dsantorojr/velocity/JP-autoset-main/autoset-main-terminal-definitions.png

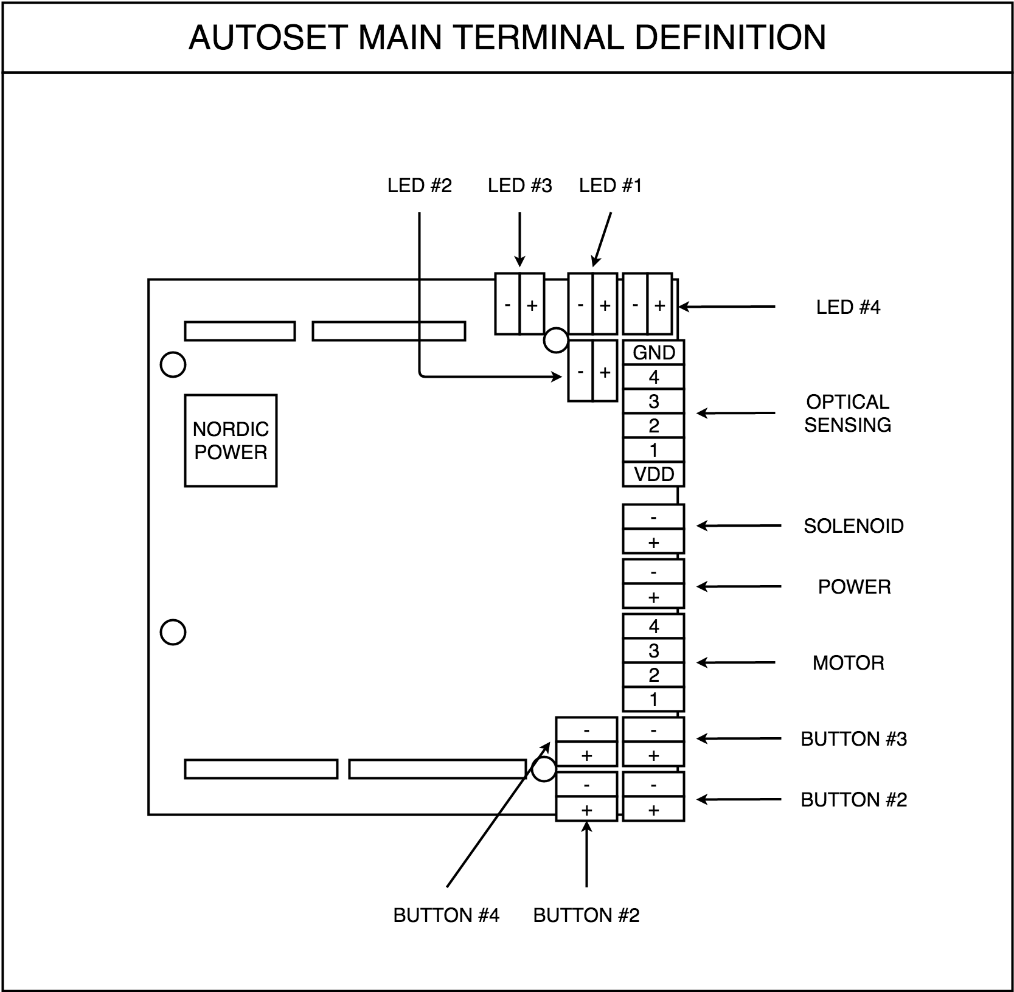
JP-autoset-main/autoset-main-terminal-definitions.png
