dsantorojr/velocity/JP-autoset-sensing-2/autoset-sensing-terminal-definition.png

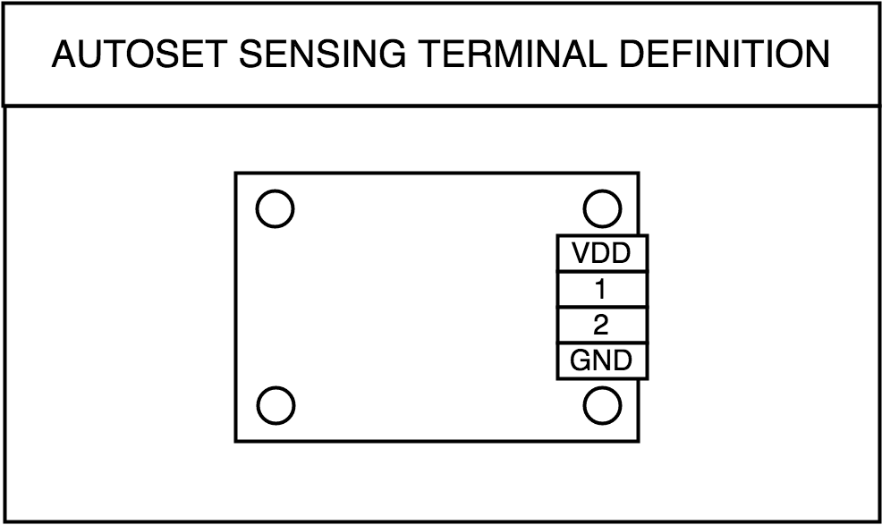
JP-autoset-sensing-2/autoset-sensing-terminal-definition.png
