dsantorojr/velocity/JP-autoset-main/autoset-main-in.dxf

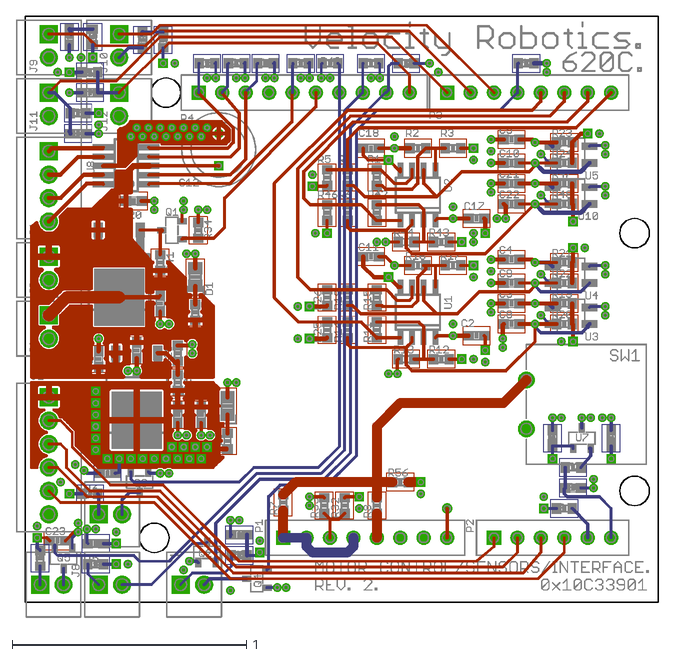
[picture p3: CAD file, 2017-01-25]
JP-autoset-main/autoset-main-in.dxf
2.74 x 2.57
