dsantorojr/velocity/JP-autoset-main/autoset-main-mm.dxf

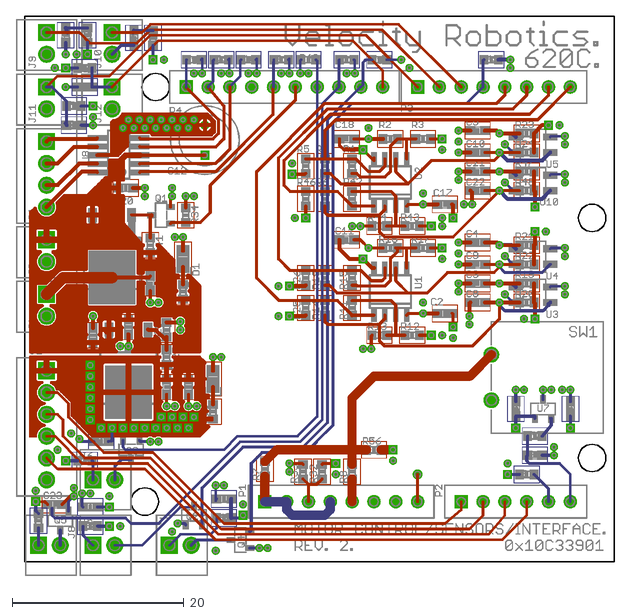
[picture p4: CAD file, 2017-01-25]
JP-autoset-main/autoset-main-mm.dxf
69.6 x 65.2
