dsantorojr/velocity/JP-autoset-sensing-2/autoset-sensing-mm.dxf

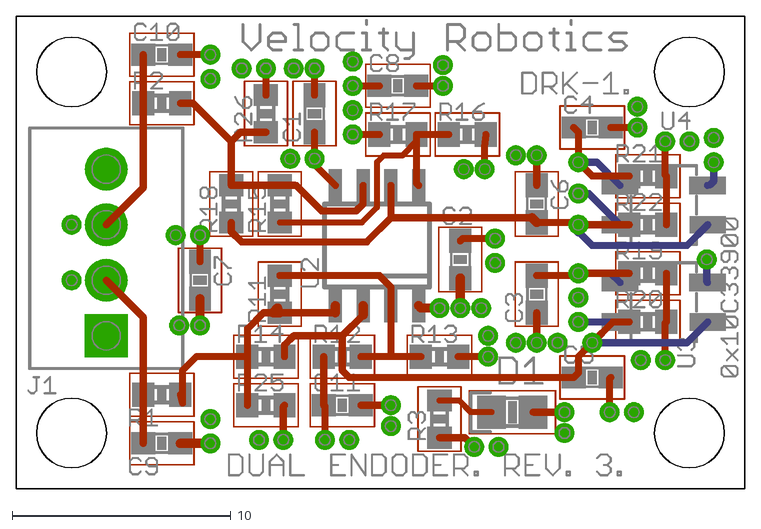
[picture p5: CAD file, 2017-01-25]
JP-autoset-sensing-2/autoset-sensing-mm.dxf
33.3 x 21.6
