dsantorojr/velocity/MF-autoset-motor-control/power-motor.dxf

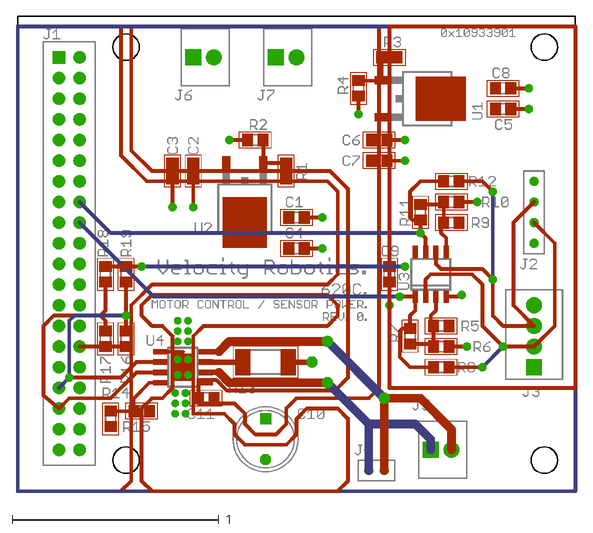
[picture p6: CAD file, 2016-12-03]
MF-autoset-motor-control/power-motor.dxf
2.72 x 2.31
