dsantorojr/velocity/MF-autoset-sensing/dual-encoding.dxf

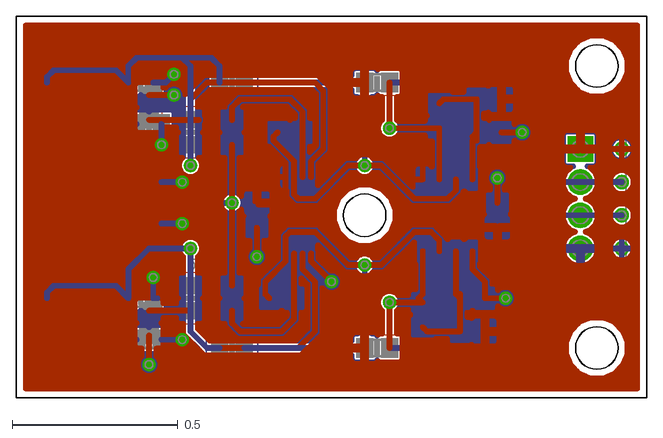
[picture p7: CAD file, 2016-12-03]
MF-autoset-sensing/dual-encoding.dxf
1.90 x 1.15
