dsantorojr/velocity/JP-autoset-sensing-2/autoset-sensing-in.dxf

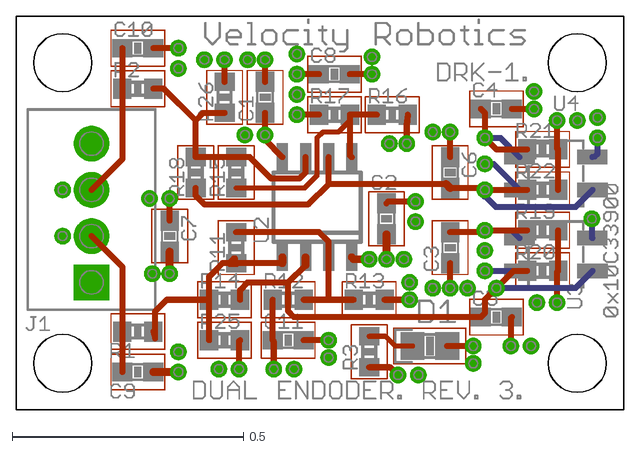
[picture p8: CAD file, 2017-01-25]
JP-autoset-sensing-2/autoset-sensing-in.dxf
1.31 x 0.85
