dsantorojr/velocity/JP-autoset-main/autoset-main-schematic.pdf

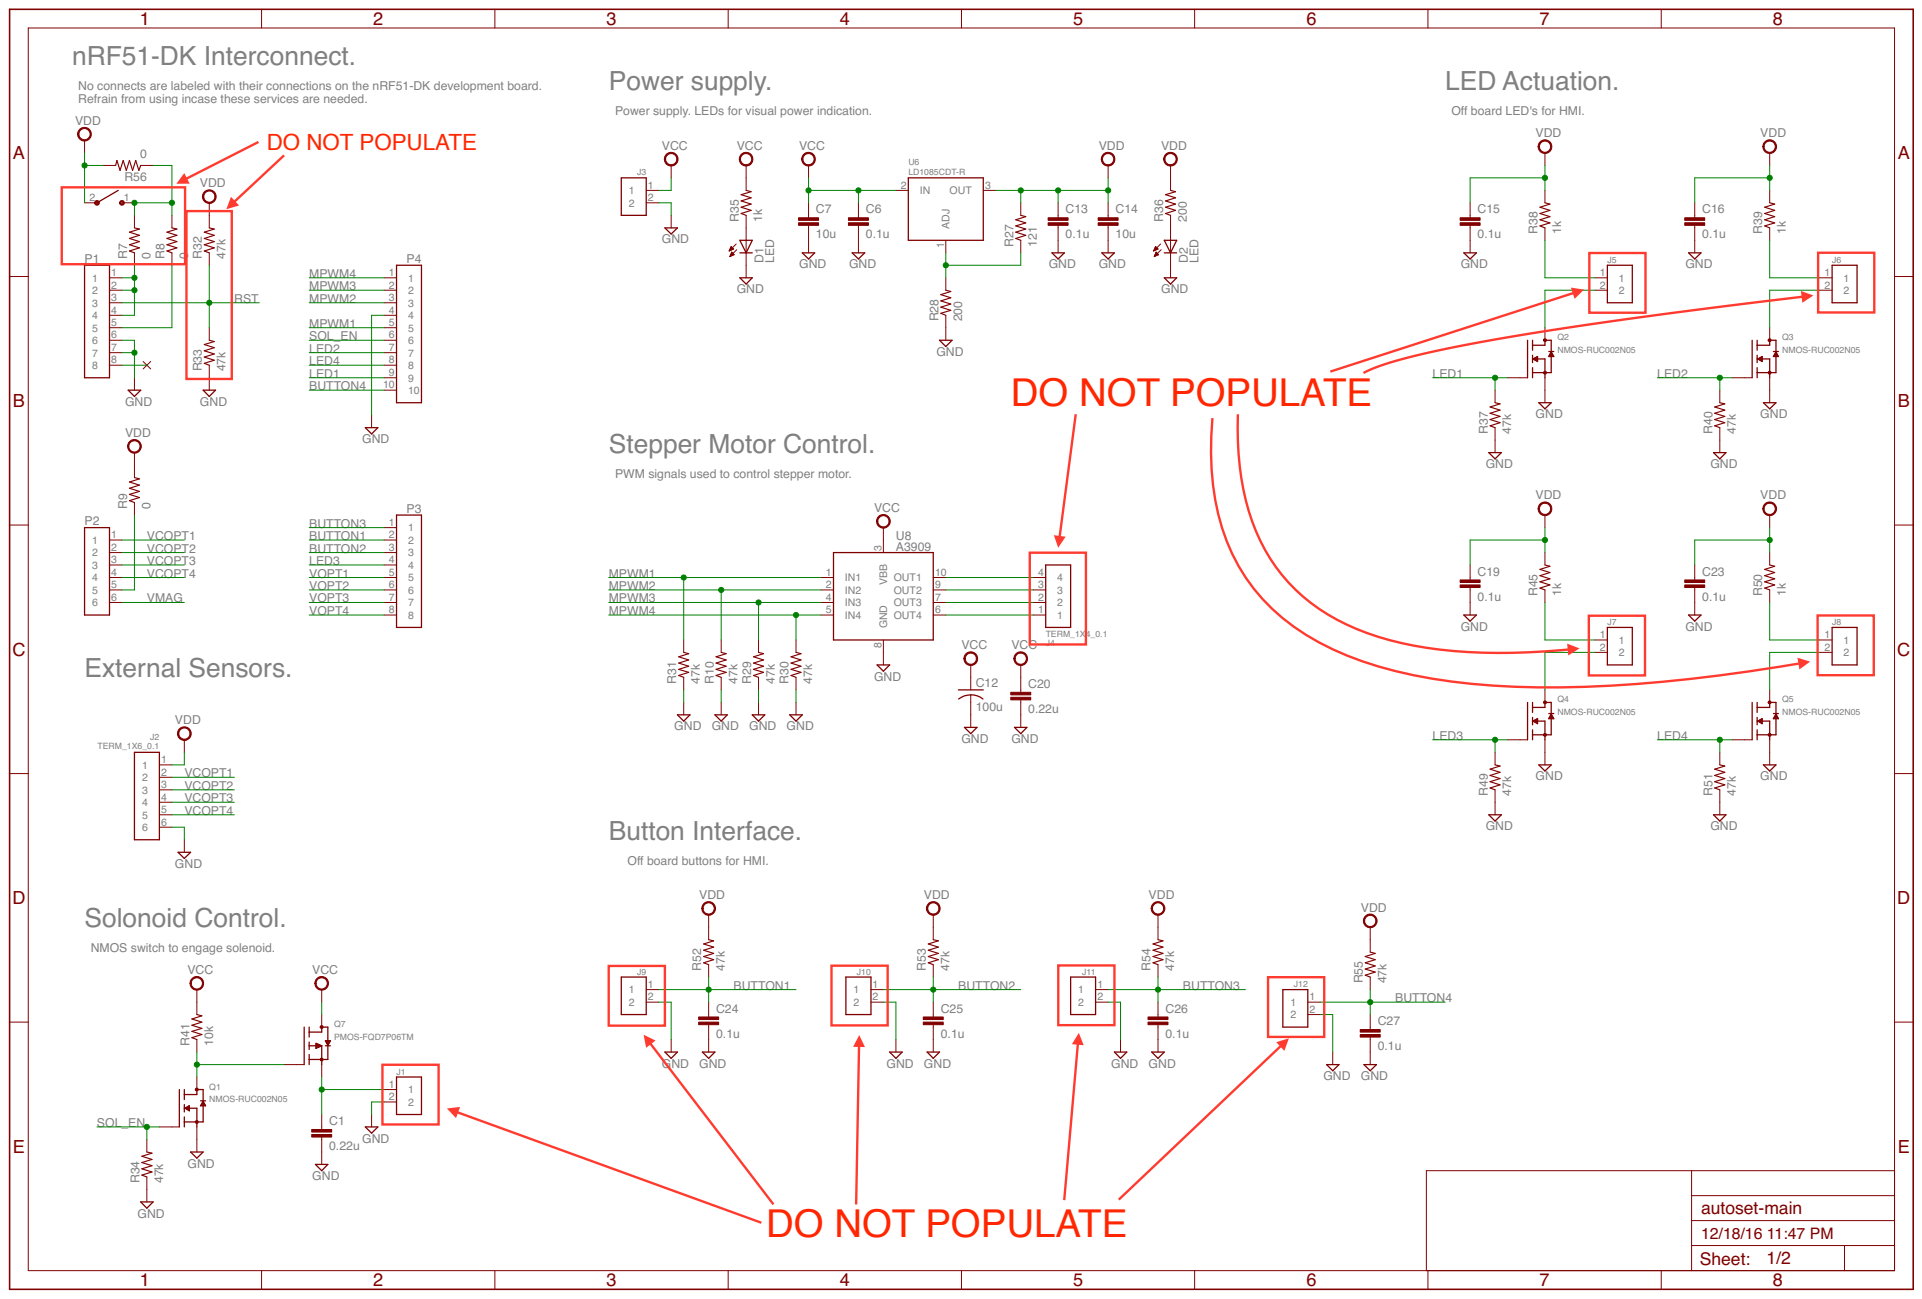
[picture p9: page 1]

nRF51-DK Interconnect. No connects are labeled with their connections on the nRF51-DK development board.

Power supply. Power supply. LEDs for visual power indication.

LED Actuation. Off board LED's for HMI.

Refrain from using incase these services are needed.
VDD

Stepper Motor Control. PWM signals used to control stepper motor.

GND GND

Button Interface. Off board buttons for HMI.

Solonoid Control. NMOS switch to engage solenoid.

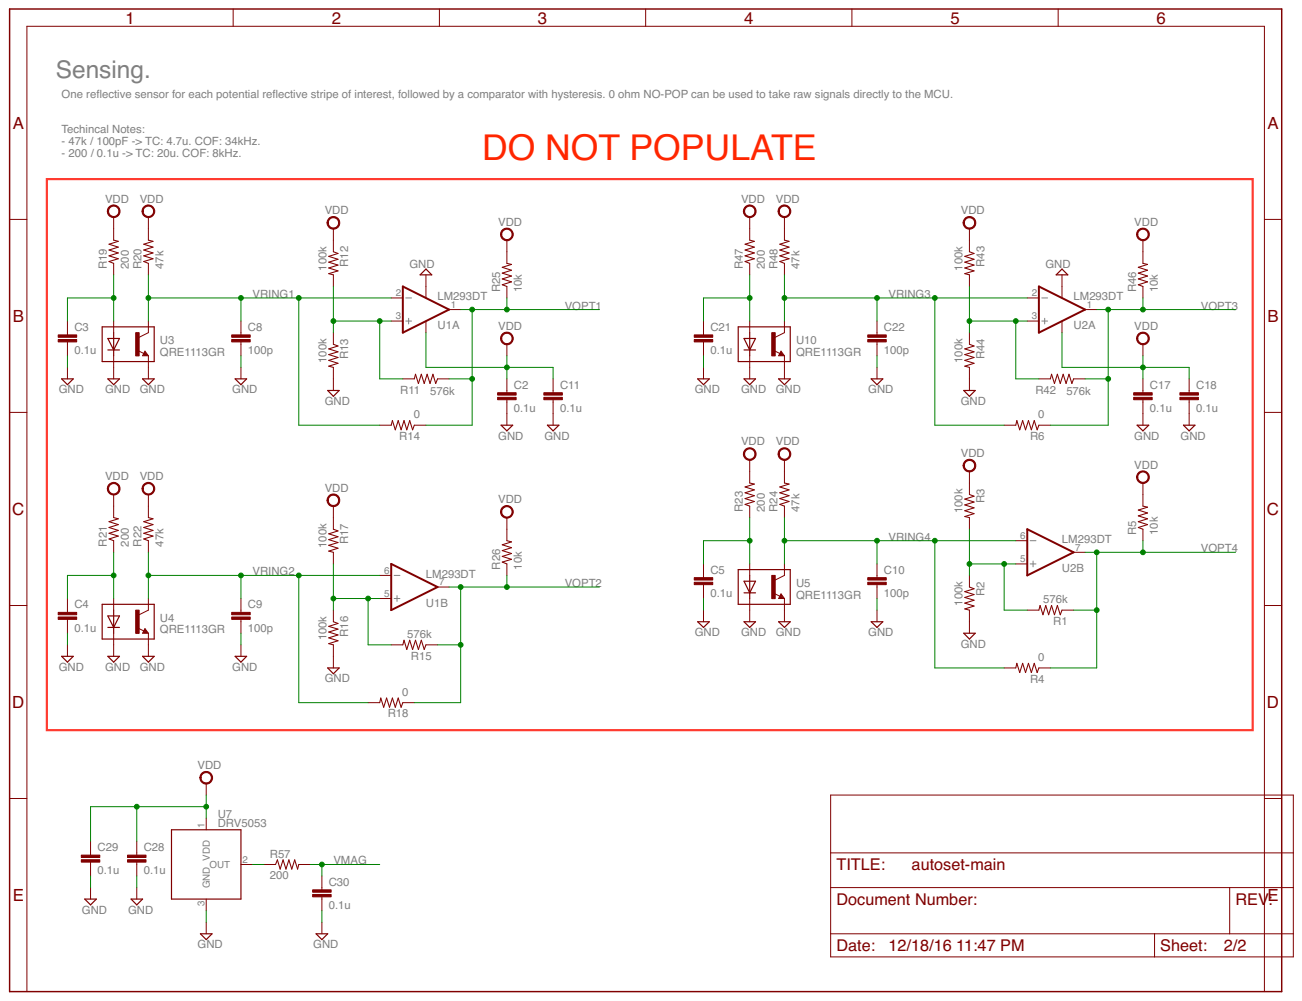
[picture p10: page 2]

Sensing. One reflective sensor for each potential reflective stripe of interest, followed by a comparator with hysteresis. 0 ohm NO-POP can be used to take raw signals directly to the MCU.

TITLE: autoset-main
Document Number: | REV: | E

Date: 12/18/16 11:47 PM | Sheet: 2/2
