dsantorojr/velocity/JP-autoset-main/autoset-main.pdf

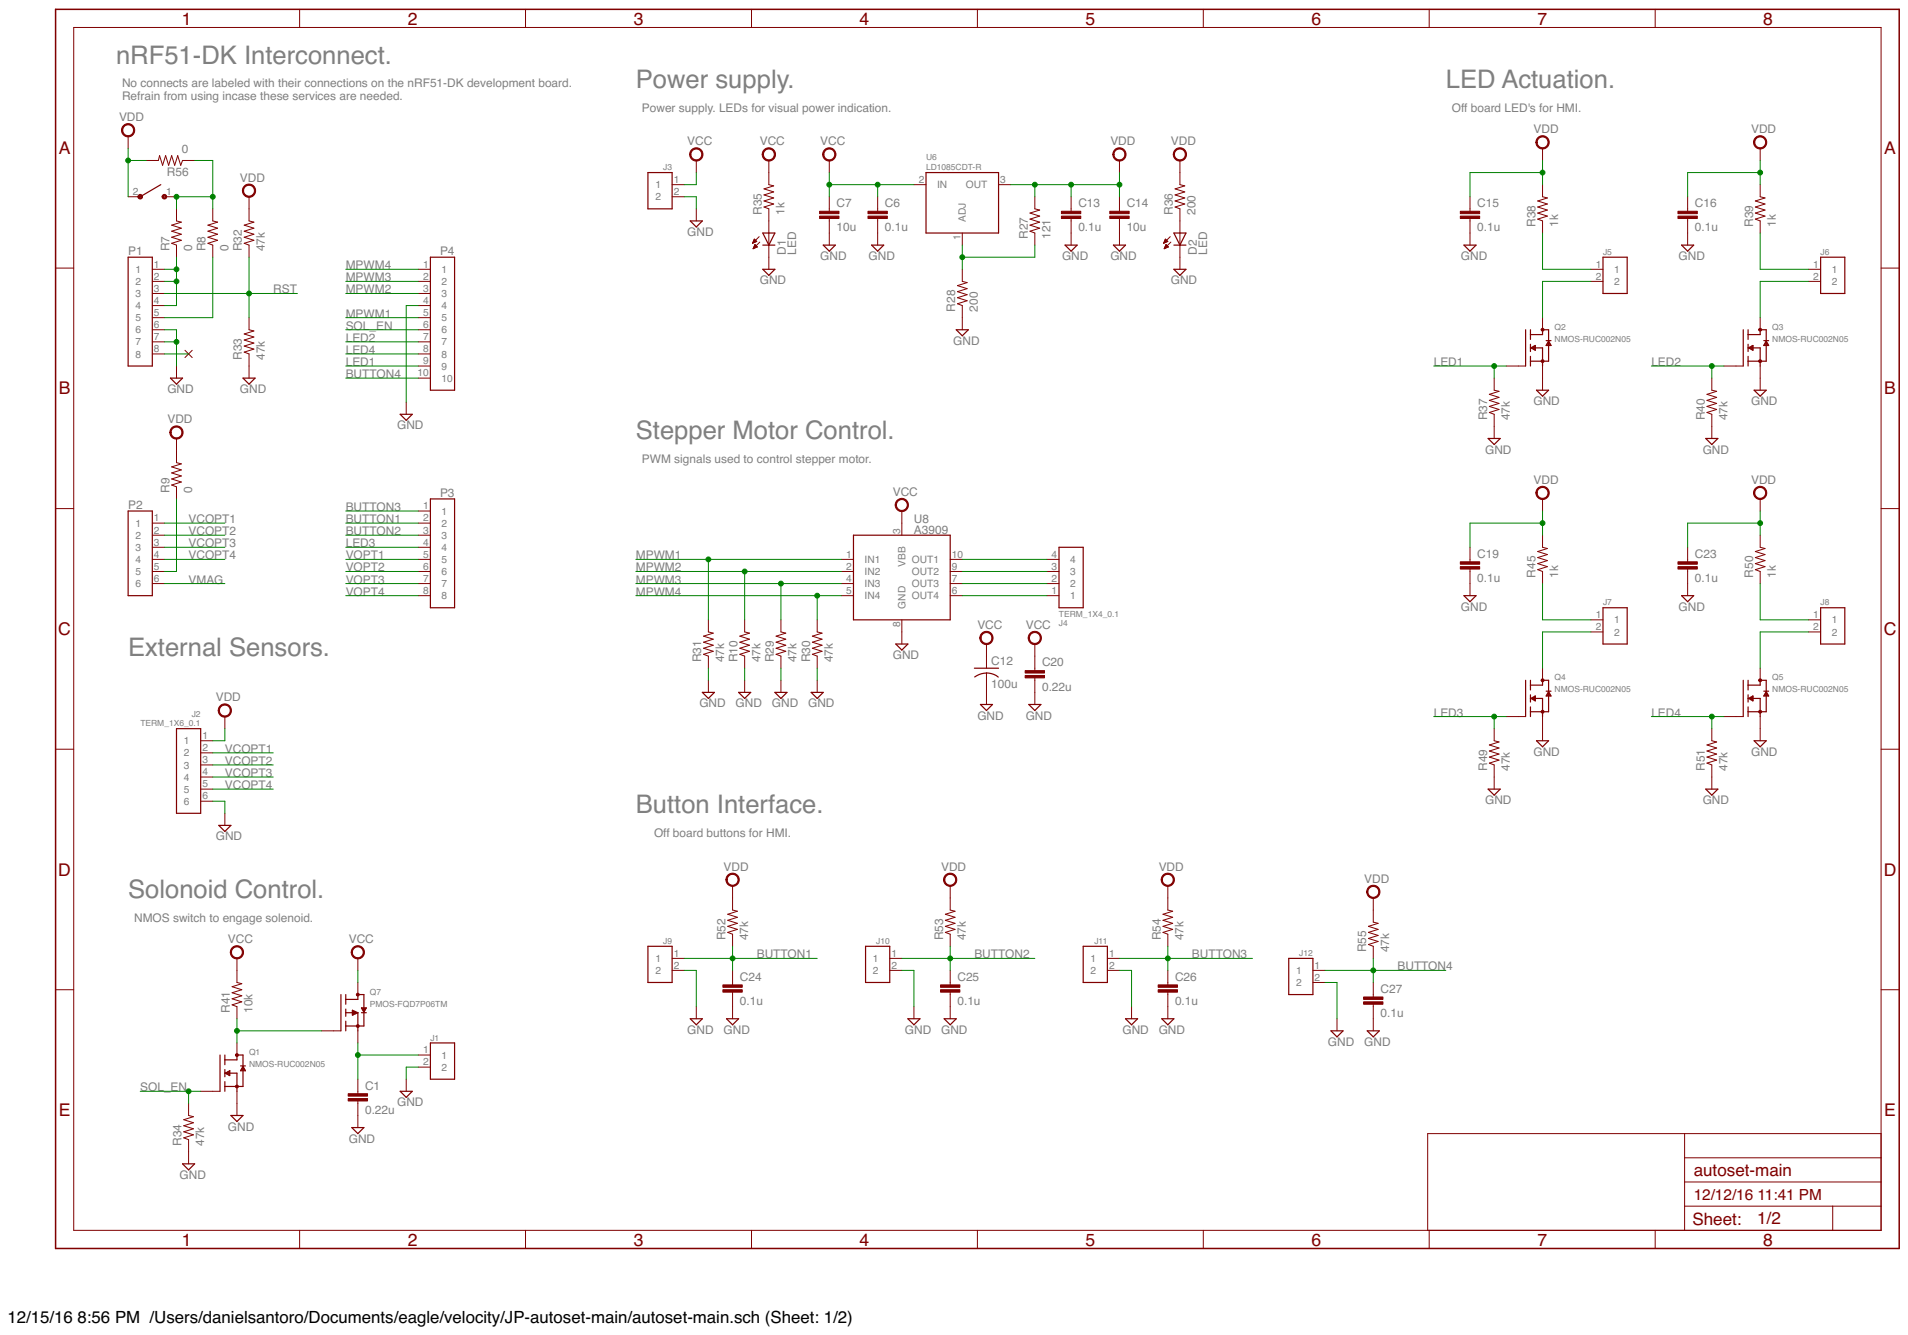
[picture p11: page 1]

LED Actuation. Off board LED's for HMI.

Stepper Motor Control. PWM signals used to control stepper motor. External Sensors.

47k GND GND GND GND

Button Interface. Off board buttons for HMI.

Solonoid Control. NMOS switch to engage solenoid.

12/15/16 8:56 PM /Users/danielsantoro/Documents/eagle/velocity/JP-autoset-main/autoset-main.sch (Sheet: 1/2)
