dsantorojr/velocity/MF-autoset-motor-control/power-motor.pdf

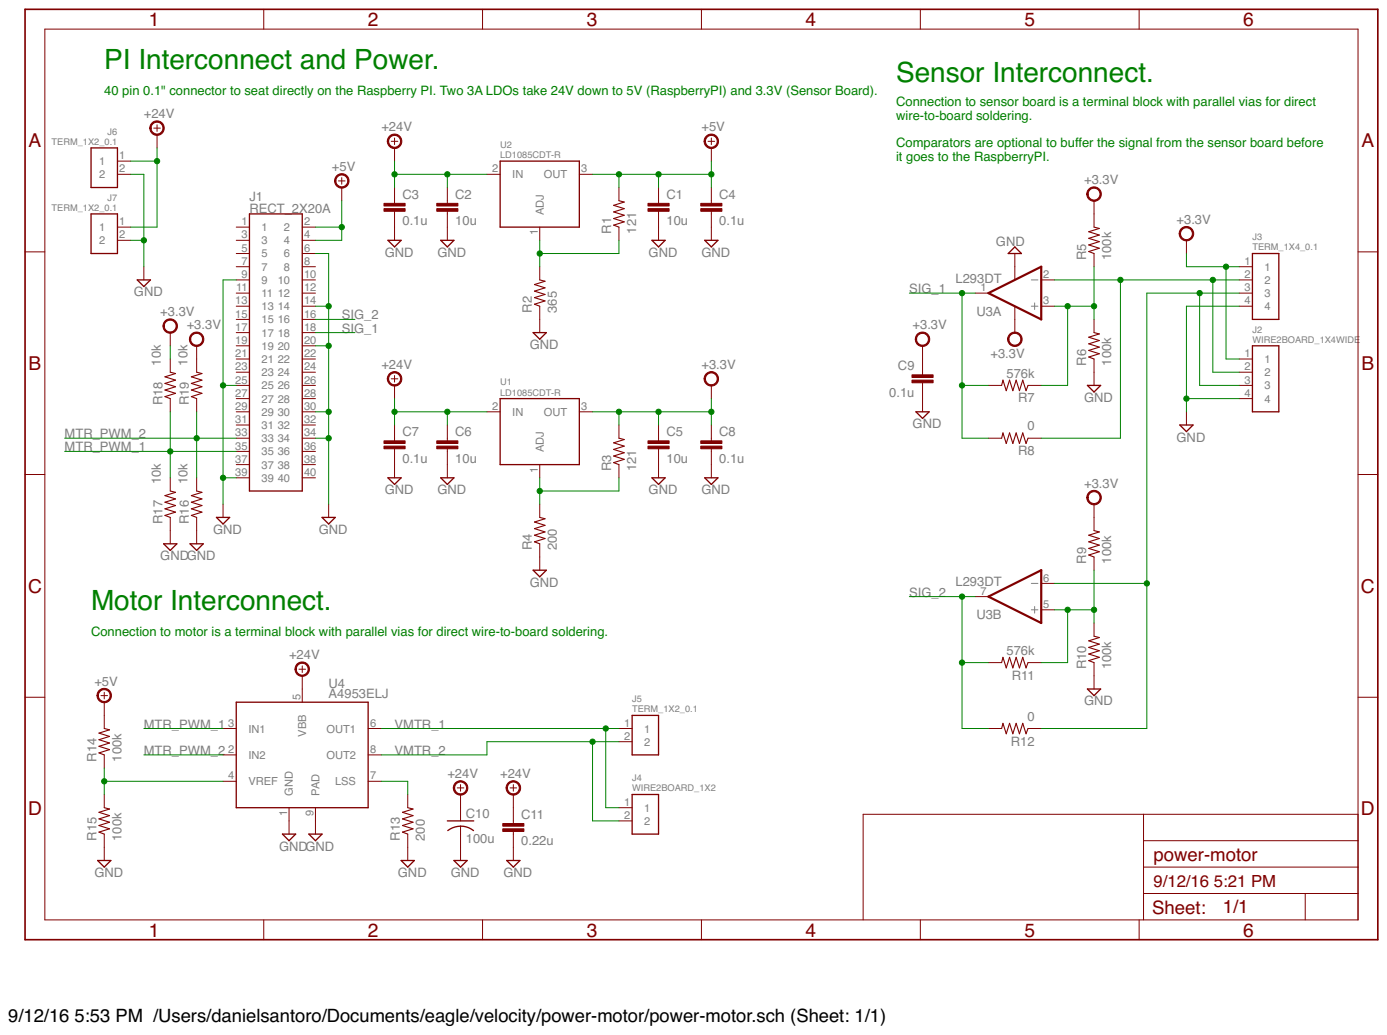
[picture p12: page 1]

PI Interconnect and Power.

Sensor Interconnect. Connection to sensor board is a terminal block with parallel vias for direct wire-to-board soldering. Comparators are optional to buffer the signal from the sensor board before

40 pin 0.1" connector to seat directly on the Raspberry PI. Two 3A LDOs take 24V down to 5V (RaspberryPI) and 3.3V (Sensor Board).

it goes to the RaspberryPI.

Motor Interconnect. Connection to motor is a terminal block with parallel vias for direct wire-to-board soldering.

9/12/16 5:53 PM /Users/danielsantoro/Documents/eagle/velocity/power-motor/power-motor.sch (Sheet: 1/1)
