dsantorojr/velocity/MF-autoset-sensing/dual-encoding.pdf

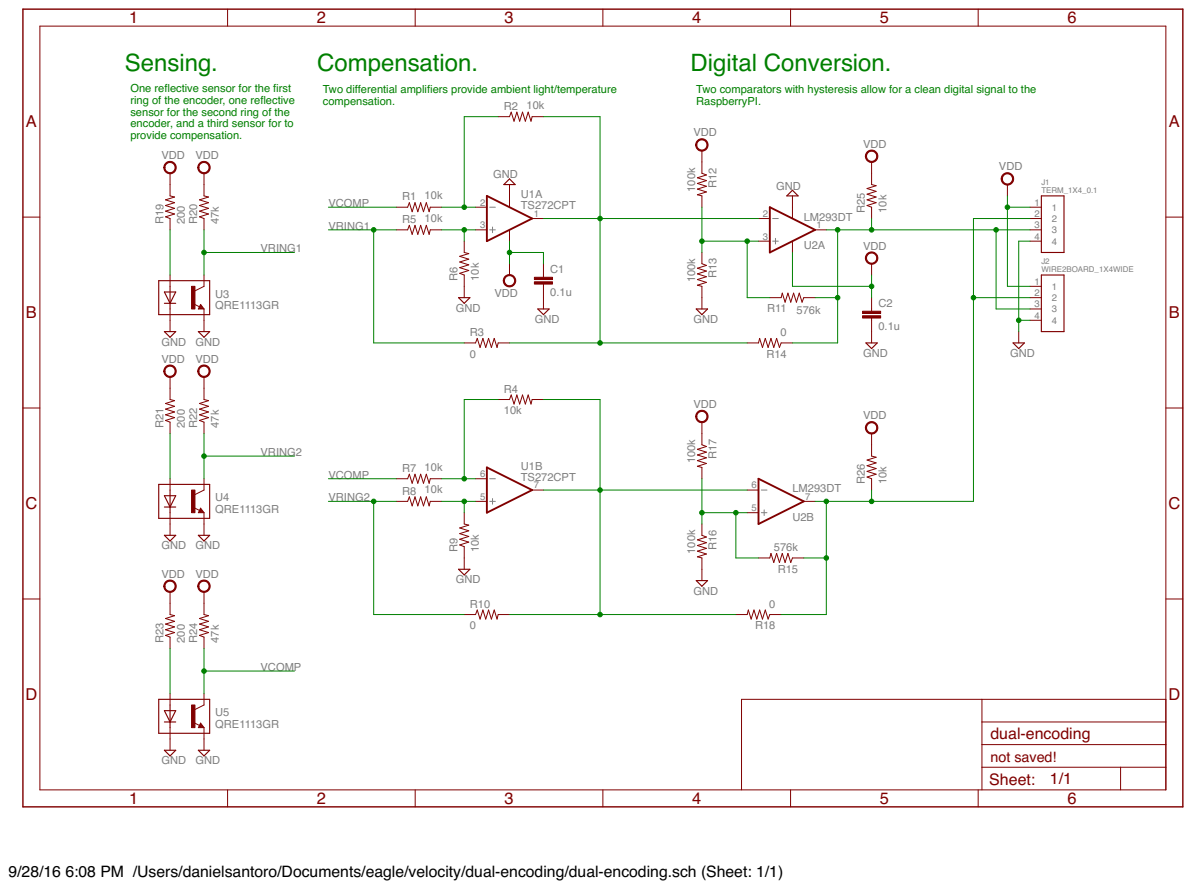
[picture p13: page 1]

compensation. One reflective sensor for the first ring of the encoder, one reflective

sensor for the second ring of the
encoder, and a third sensor for to

9/28/16 6:08 PM /Users/danielsantoro/Documents/eagle/velocity/dual-encoding/dual-encoding.sch (Sheet: 1/1)
