dsantorojr/velocity/JP-autoset-main/autoset-main-layout.pdf

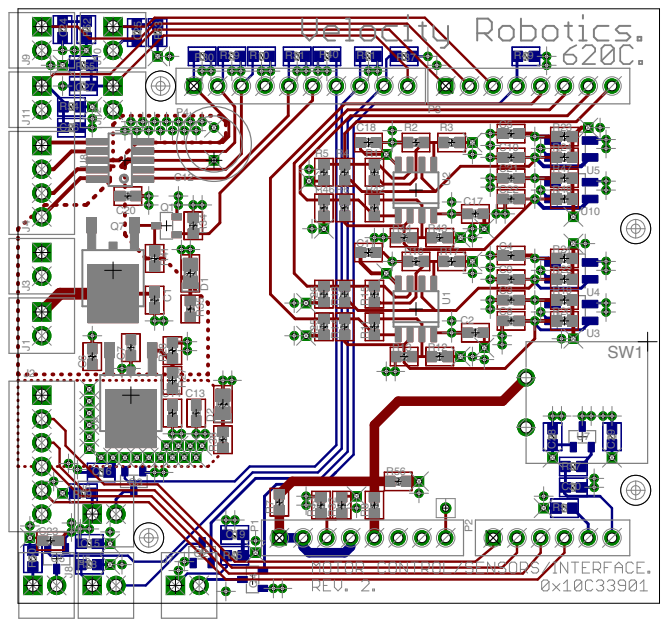
[picture p14: page 1]
