dsantorojr/velocity/JP-autoset-sensing-2/autoset-sensing-layout.pdf

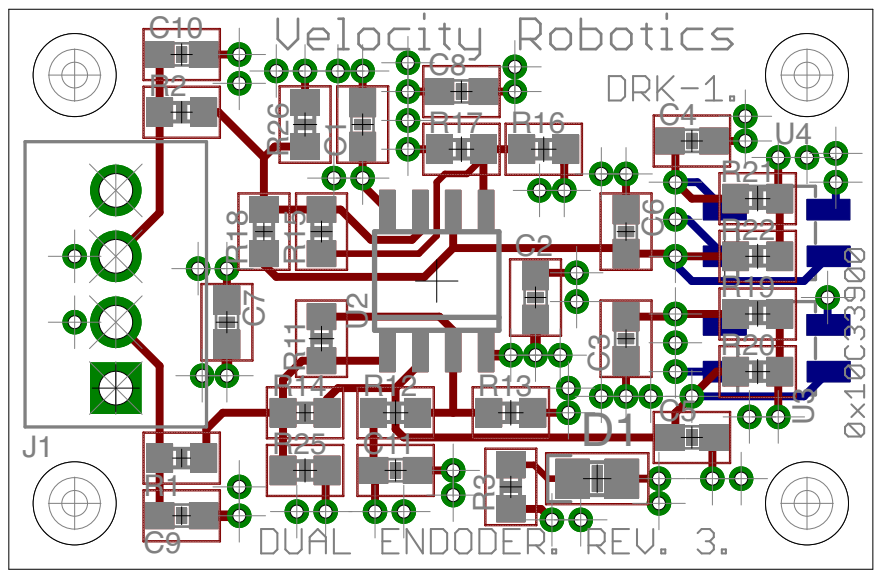
[picture p15: page 1]
