dsantorojr/velocity/JP-autoset-sensing-2/autoset-sensing.brd

## EAGLE design JP-autoset-sensing-2/autoset-sensing.brd (2017-02-26)

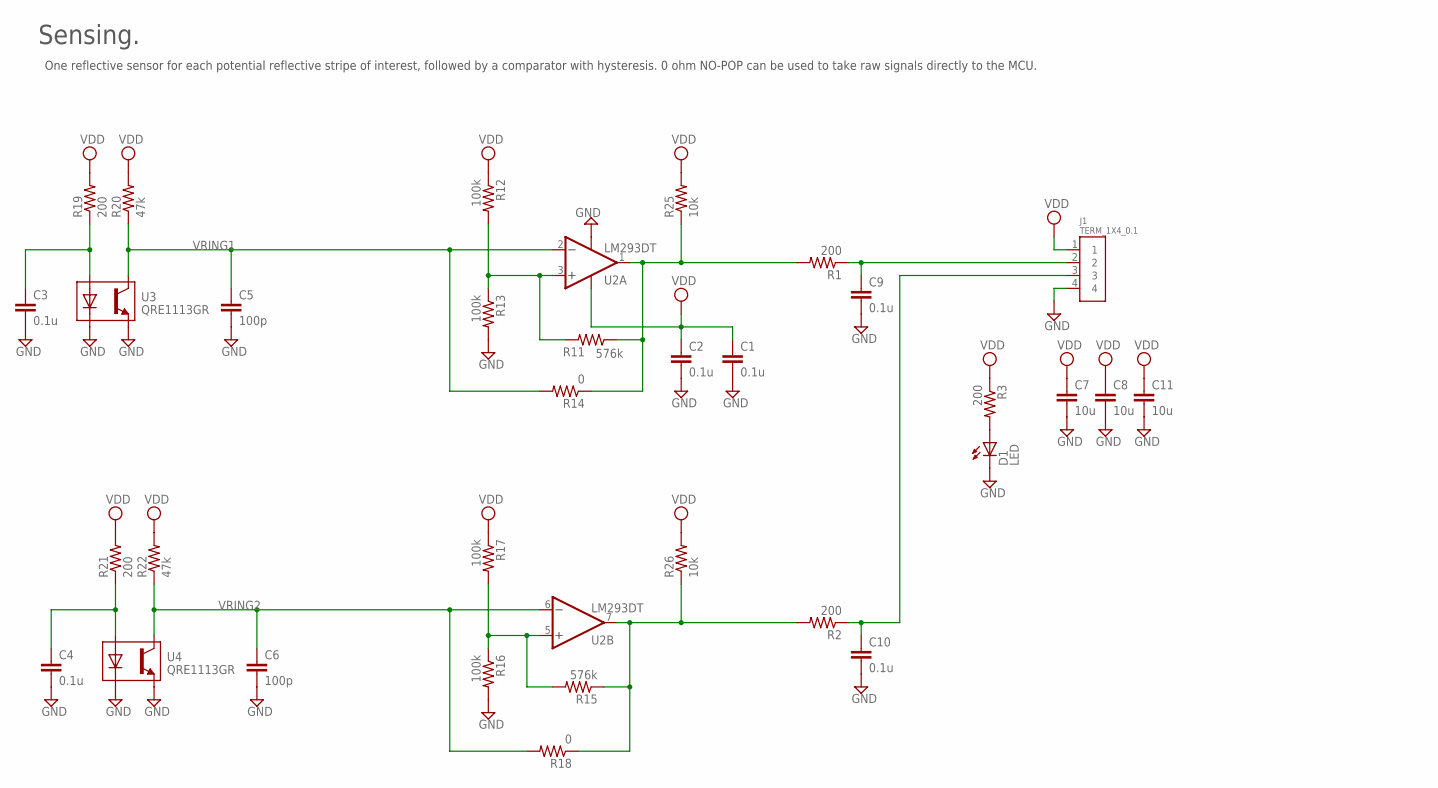
[picture p16: schematic autoset-sensing.sch]

Parts:
C1, C2, C3, C4, C9, C10: 0.1u; C0603
C5, C6: 100p; C0603
C7, C8, C11: 10u; C0603
D1: LED; L0805
J1: TERM_1X4_0.1
R1, R2, R3, R19, R21: 200; R0603
R11, R15: 576k; R0603
R12, R13, R16, R17: 100k; R0603
R14, R18: 0; R0603
R20, R22: 47k; R0603
R25, R26: 10k; R0603
U2: LM293DT; SOIC8
U3, U4: QRE1113GR; REFL

Connections:
GND: C1.2, C2.2, C3.2, C4.2, C5.2, C6.2, C7.2, C8.2, C9.2, C10.2, C11.2, D1.2 (C), J1.4, R13.2, R16.2, U2.4 (V-), U3.2 (DC), U3.4 (E), U4.2 (DC), U4.4 (E)
unnamed: C9.1, J1.2, R1.1
unnamed: C10.1, J1.3, R2.1
unnamed: D1.1 (A), R3.2
unnamed: R11.2, R12.2, R13.1, U2.3 (+IN)
unnamed: R1.2, R11.1, R14.1, R25.1, U2.1 (OUT)
unnamed: C3.1, R19.1, U3.1 (DA)
unnamed: R15.2, R16.1, R17.2, U2.5 (+IN)
unnamed: R2.2, R15.1, R18.1, R26.1, U2.7 (OUT)
unnamed: C4.1, R21.1, U4.1 (DA)
VDD: C1.1, C2.1, C7.1, C8.1, C11.1, J1.1, R3.1, R12.1, R17.1, R19.2, R20.2, R21.2, R22.2, R25.2, R26.2, U2.8 (V+)
VRING1: C5.1, R14.2, R20.1, U2.2 (-IN), U3.3 (C)
VRING2: C6.1, R18.2, R22.1, U2.6 (-IN), U4.3 (C)

Notes on the sheet:
Sensing.
One reflective sensor for each potential reflective stripe of interest, followed by a comparator with hysteresis. 0 ohm NO-POP can be used to take raw signals directly to the MCU.

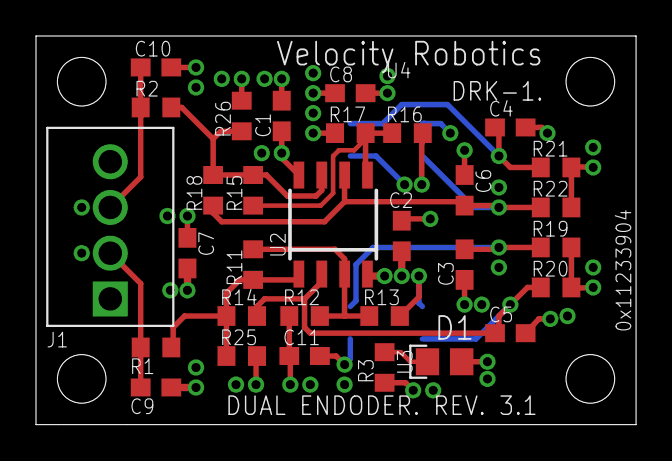
[picture p17: board autoset-sensing.brd from above]

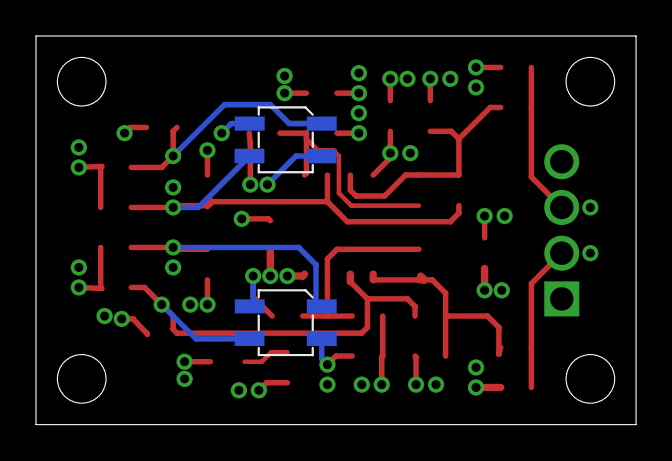
[picture p18: board autoset-sensing.brd from below]

Board: 4 copper layers, 33.3 x 21.6 mm, 33 parts (2 on the bottom side), 13 nets.
