dsantorojr/velocity/JP-autoset-main/autoset-main.brd

## EAGLE design JP-autoset-main/autoset-main.brd (2017-01-25)

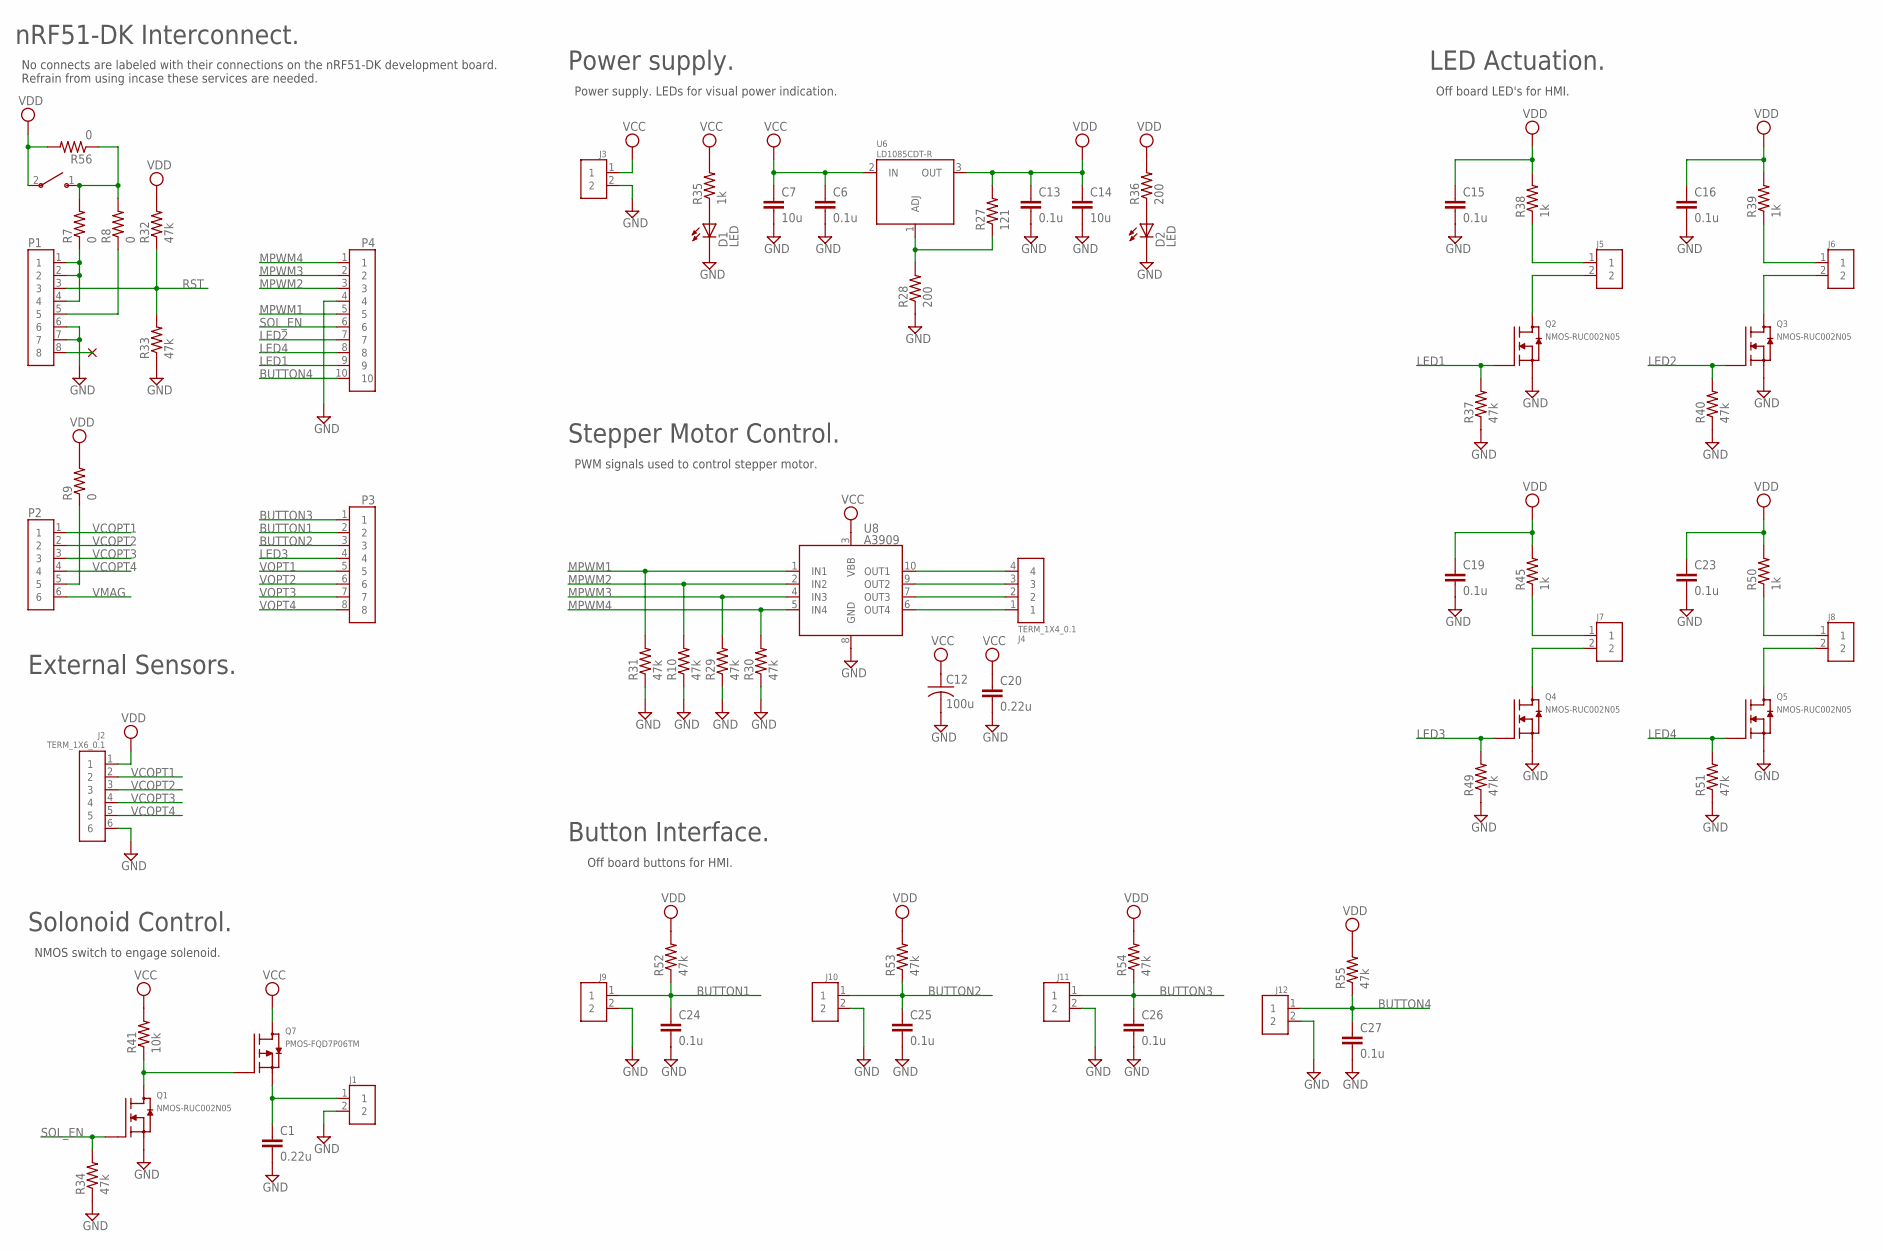
[picture p19: schematic autoset-main.sch, sheet 1]

Parts:
C1, C20: 0.22u; C0603
C6, C13, C15, C16, C19, C23, C24, C25, C26, C27: 0.1u; C0603
C7, C14: 10u; C0603
C12: 100u; CPOL-3.5MM
D1, D2: LED; L0805
J1, J3, J5, J6, J7, J8, J9, J10, J11, J12: TERM_1X2_0.1
J2: TERM_1X6_0.1
J4: TERM_1X4_0.1
P1, P3: RECT_1X8; RECT_1X8_0.1
P2: RECT_1X6; RECT_1X6_0.1
P4: RECT_1X10; RECT_1X10_0.1
Q1, Q2, Q3, Q4, Q5: NMOS-RUC002N05; SOT23
Q7: PMOS-FQD7P06TM; TO252
R7, R8, R9, R56: 0; R0603
R10, R29, R30, R31, R32, R33, R34, R37, R40, R49, R51, R52, R53, R54, R55: 47k; R0603
R27: 121; R0603
R28, R36: 200; R0603
R35, R38, R39, R45, R50: 1k; R0603
R41: 10k; R0603
SW1: GPTS203211B
U6: LD1085CDT-R; TO252
U8: A3909; SSOP10
Z15: NC; NC_TH

Connections:
BUTTON1: C24.1, J9.1, P3.2, R52.1
BUTTON2: C25.1, J10.1, P3.3, R53.1
BUTTON3: C26.1, J11.1, P3.1, R54.1
BUTTON4: C27.1, J12.1, P4.10, R55.1
GND: C1.2, C6.2, C7.2, C12.P$2 (2), C13.2, C14.2, C15.2, C16.2, C19.2, C20.2, C23.2, C24.2, C25.2, C26.2, C27.2, D1.2 (C), D2.2 (C), J1.2, J2.6, J3.2, J9.2, J10.2, J11.2, J12.2, P1.6, P1.7, P4.4, Q1.1 (S), Q2.1 (S), Q3.1 (S), Q4.1 (S), Q5.1 (S), R10.1, R28.1, R29.1, R30.1, R31.1, R33.1, R34.1, R37.1, R40.1, R49.1, R51.1, U8.8 (GND); also elsewhere on the board
LED1: P4.9, Q2.2 (G), R37.2
LED2: P4.7, Q3.2 (G), R40.2
LED3: P3.4, Q4.2 (G), R49.2
LED4: P4.8, Q5.2 (G), R51.2
MPWM1: P4.5, R31.2, U8.1 (IN1)
MPWM2: P4.3, R10.2, U8.2 (IN2)
MPWM3: P4.2, R29.2, U8.4 (IN3)
MPWM4: P4.1, R30.2, U8.5 (IN4)
unnamed: P1.8, Z15.P$1
unnamed: J6.2, Q3.3 (D)
unnamed: R7.2, R8.2, R56.1, SW1.1
unnamed: P1.1, P1.2, P1.4, R7.1
unnamed: J4.4, U8.10 (OUT1)
unnamed: R27.1, R28.2, U6.1 (ADJ)
unnamed: J4.3, U8.9 (OUT2)
unnamed: J5.2, Q2.3 (D)
unnamed: J5.1, R38.1
unnamed: J6.1, R39.1
unnamed: J7.2, Q4.3 (D)
unnamed: J7.1, R45.1
unnamed: J8.2, Q5.3 (D)
unnamed: J4.2, U8.7 (OUT3)
unnamed: J4.1, U8.6 (OUT4)
unnamed: J8.1, R50.1
unnamed: P2.5, R9.1
unnamed: C1.1, J1.1, Q7.3 (D)
unnamed: P1.5, R8.1
unnamed: Q1.3 (D), Q7.1 (G), R41.1
unnamed: D1.1 (A), R35.1
unnamed: D2.1 (A), R36.1
RST: P1.3, R32.1, R33.2
SOL_EN: P4.6, Q1.2 (G), R34.2
VCC: C6.1, C7.1, C12.P$1 (1), C20.1, J3.1, Q7.2 (S), R35.2, R41.2, U6.2 (IN), U8.3 (VBB)
VCOPT1: J2.2, P2.1
VCOPT2: J2.3, P2.2
VCOPT3: J2.4, P2.3
VCOPT4: J2.5, P2.4
VDD: C13.1, C14.1, C15.1, C16.1, C19.1, C23.1, J2.1, R9.2, R27.2, R32.2, R36.2, R38.2, R39.2, R45.2, R50.2, R52.2, R53.2, R54.2, R55.2, R56.2, SW1.2, U6.3 (OUT); also elsewhere on the board
VMAG: P2.6; also elsewhere on the board
VOPT1: P3.5; also elsewhere on the board
VOPT2: P3.6; also elsewhere on the board
VOPT3: P3.7; also elsewhere on the board
VOPT4: P3.8; also elsewhere on the board

Notes on the sheet:
nRF51-DK Interconnect.
No connects are labeled with their connections on the nRF51-DK development board. Refrain from using incase these services are needed.
Power supply.
Power supply. LEDs for visual power indication.
Solonoid Control.
NMOS switch to engage solenoid.
Stepper Motor Control.
PWM signals used to control stepper motor.
External Sensors.
LED Actuation.
Off board LED's for HMI.
Button Interface.
Off board buttons for HMI.

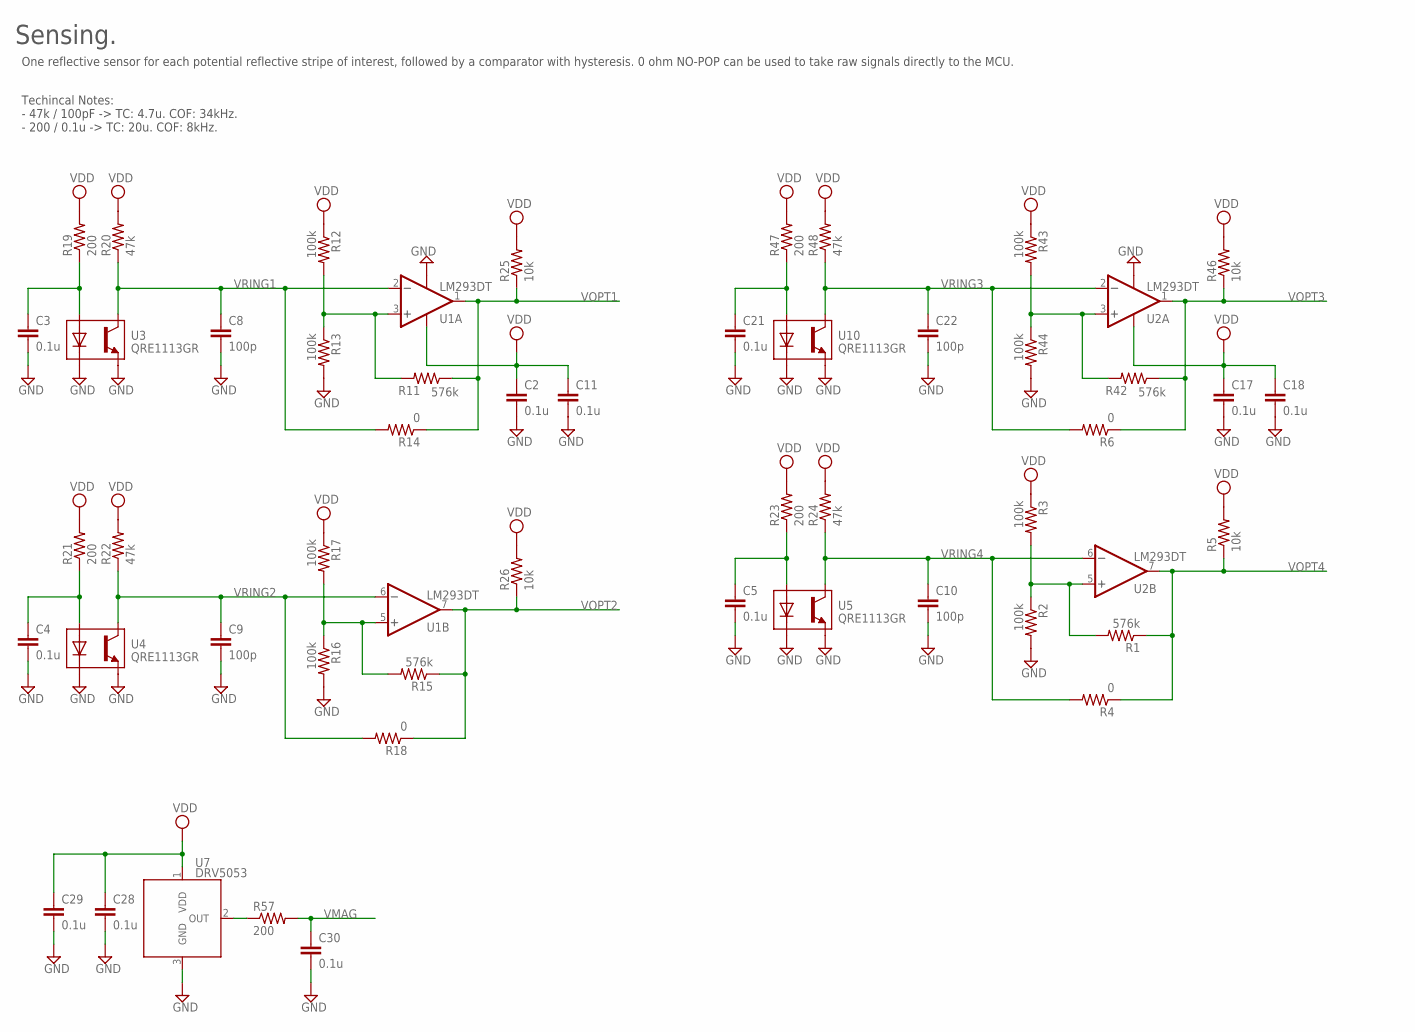
[picture p20: schematic autoset-main.sch, sheet 2]

Parts:
C2, C3, C4, C5, C11, C17, C18, C21, C28, C29, C30: 0.1u; C0603
C8, C9, C10, C22: 100p; C0603
R1, R11, R15, R42: 576k; R0603
R2, R3, R12, R13, R16, R17, R43, R44: 100k; R0603
R4, R6, R14, R18: 0; R0603
R5, R25, R26, R46: 10k; R0603
R19, R21, R23, R47, R57: 200; R0603
R20, R22, R24, R48: 47k; R0603
U1, U2: LM293DT; SOIC8
U3, U4, U5, U10: QRE1113GR; REFL
U7: DRV5053; SOT23

Connections:
GND: C2.2, C3.2, C4.2, C5.2, C8.2, C9.2, C10.2, C11.2, C17.2, C18.2, C21.2, C22.2, C28.2, C29.2, C30.2, R2.2, R13.2, R16.2, R44.2, U1.4 (V-), U2.4 (V-), U3.2 (DC), U3.4 (E), U4.2 (DC), U4.4 (E), U5.2 (DC), U5.4 (E), U7.3 (GND), U10.2 (DC), U10.4 (E); also elsewhere on the board
unnamed: R1.2, R2.1, R3.2, U2.5 (+IN)
unnamed: R42.2, R43.2, R44.1, U2.3 (+IN)
unnamed: R11.2, R12.2, R13.1, U1.3 (+IN)
unnamed: C3.1, R19.1, U3.1 (DA)
unnamed: R15.2, R16.1, R17.2, U1.5 (+IN)
unnamed: C4.1, R21.1, U4.1 (DA)
unnamed: C5.1, R23.1, U5.1 (DA)
unnamed: R57.1, U7.2 (OUT)
unnamed: C21.1, R47.1, U10.1 (DA)
VDD: C2.1, C11.1, C17.1, C18.1, C28.1, C29.1, R3.1, R5.2, R12.1, R17.1, R19.2, R20.2, R21.2, R22.2, R23.2, R24.2, R25.2, R26.2, R43.1, R46.2, R47.2, R48.2, U1.8 (V+), U2.8 (V+), U7.1 (VDD); also elsewhere on the board
VMAG: C30.1, R57.2; also elsewhere on the board
VOPT1: R11.1, R14.1, R25.1, U1.1 (OUT); also elsewhere on the board
VOPT2: R15.1, R18.1, R26.1, U1.7 (OUT); also elsewhere on the board
VOPT3: R6.1, R42.1, R46.1, U2.1 (OUT); also elsewhere on the board
VOPT4: R1.1, R4.1, R5.1, U2.7 (OUT); also elsewhere on the board
VRING1: C8.1, R14.2, R20.1, U1.2 (-IN), U3.3 (C)
VRING2: C9.1, R18.2, R22.1, U1.6 (-IN), U4.3 (C)
VRING3: C22.1, R6.2, R48.1, U2.2 (-IN), U10.3 (C)
VRING4: C10.1, R4.2, R24.1, U2.6 (-IN), U5.3 (C)

Notes on the sheet:
Sensing.
One reflective sensor for each potential reflective stripe of interest, followed by a comparator with hysteresis. 0 ohm NO-POP can be used to take raw signals directly to the MCU.
Techincal Notes: - 47k / 100pF -> TC: 4.7u. COF: 34kHz. - 200 / 0.1u -> TC: 20u. COF: 8kHz.

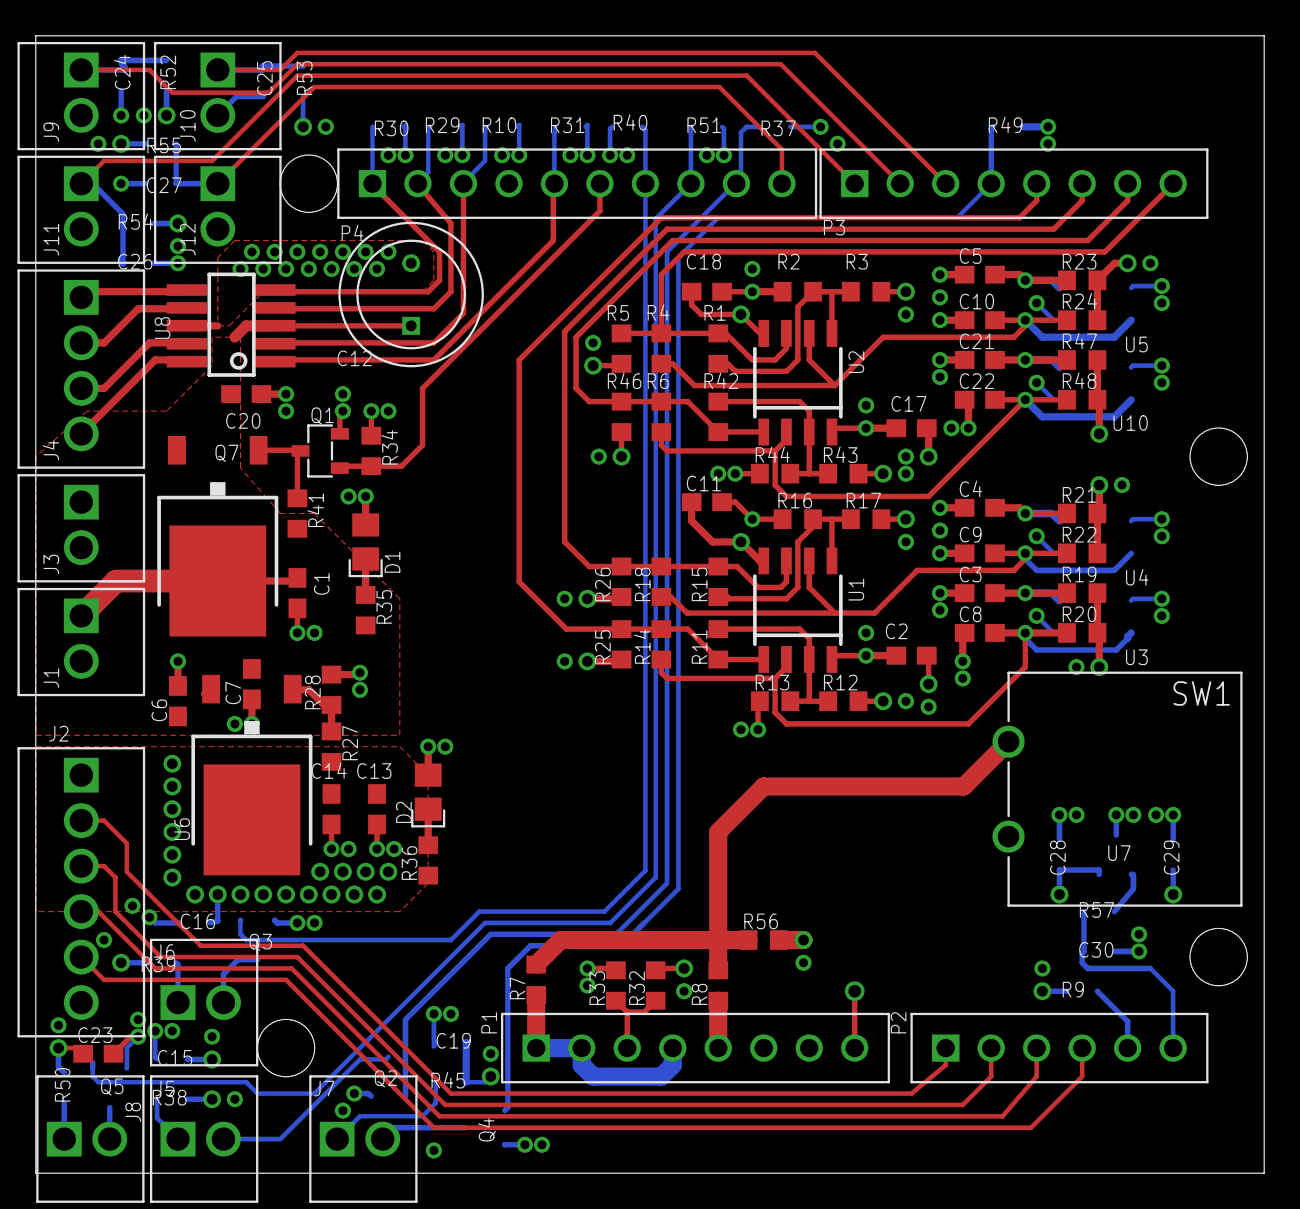
[picture p21: board autoset-main.brd from above]

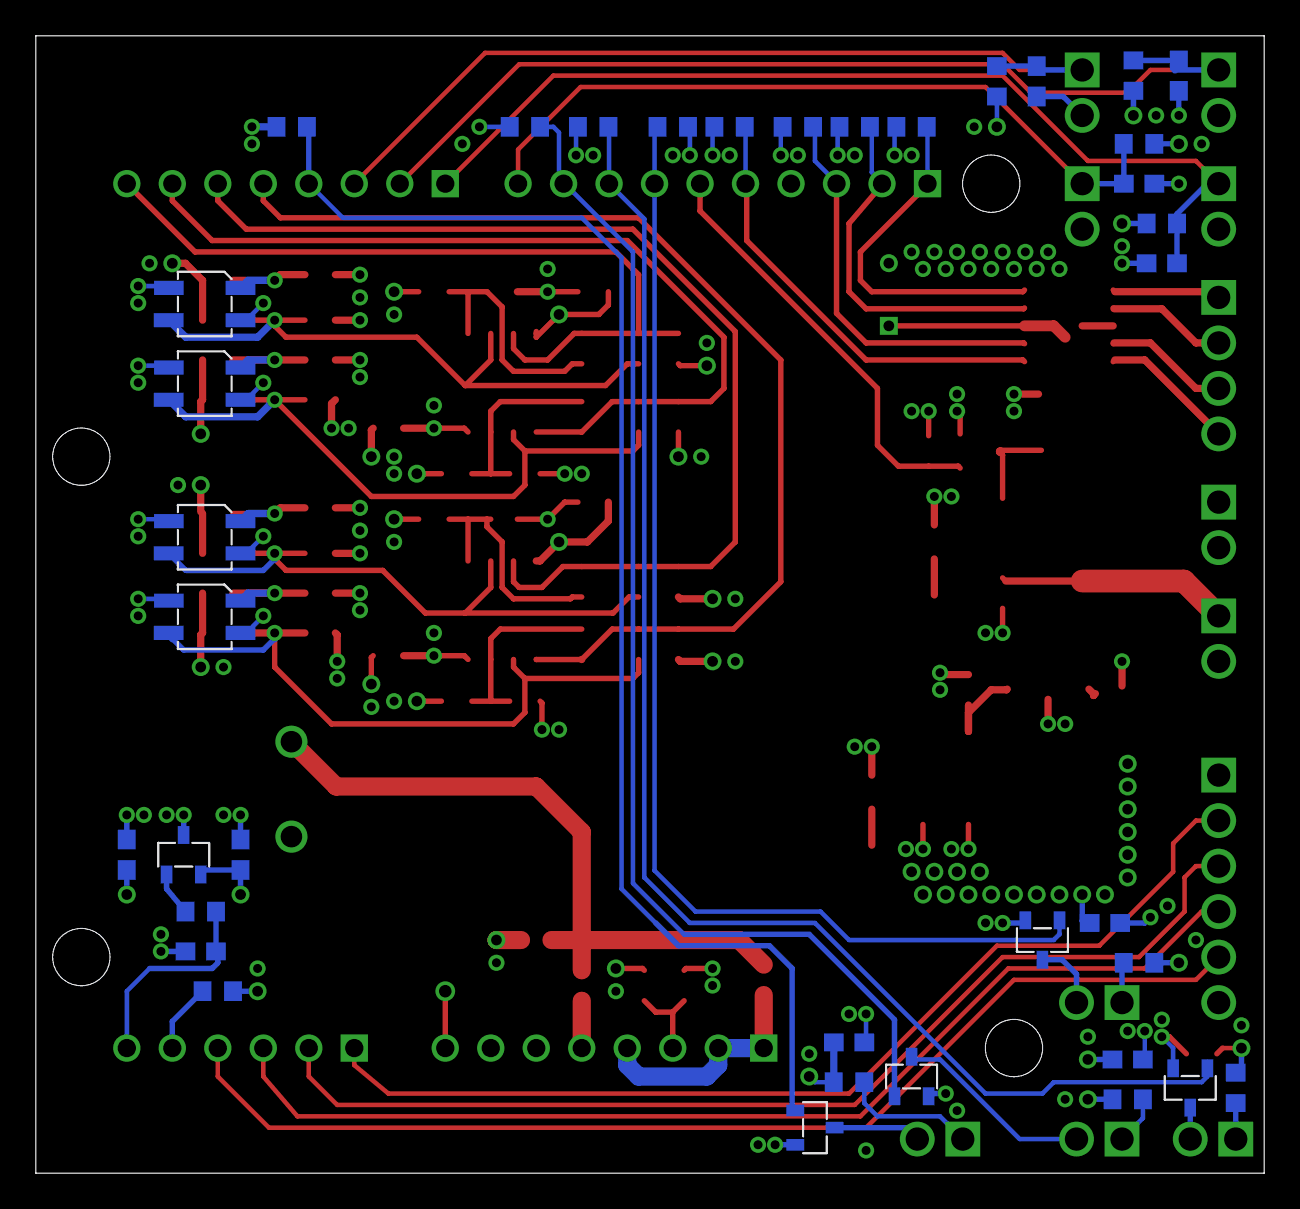
[picture p22: board autoset-main.brd from below]

Board: 4 copper layers, 68.6 x 63.5 mm, 122 parts (37 on the bottom side), 61 nets.
