dsantorojr/velocity/MF-autoset-sensing/dual-encoding.brd

## EAGLE design MF-autoset-sensing/dual-encoding.brd (2016-12-03)

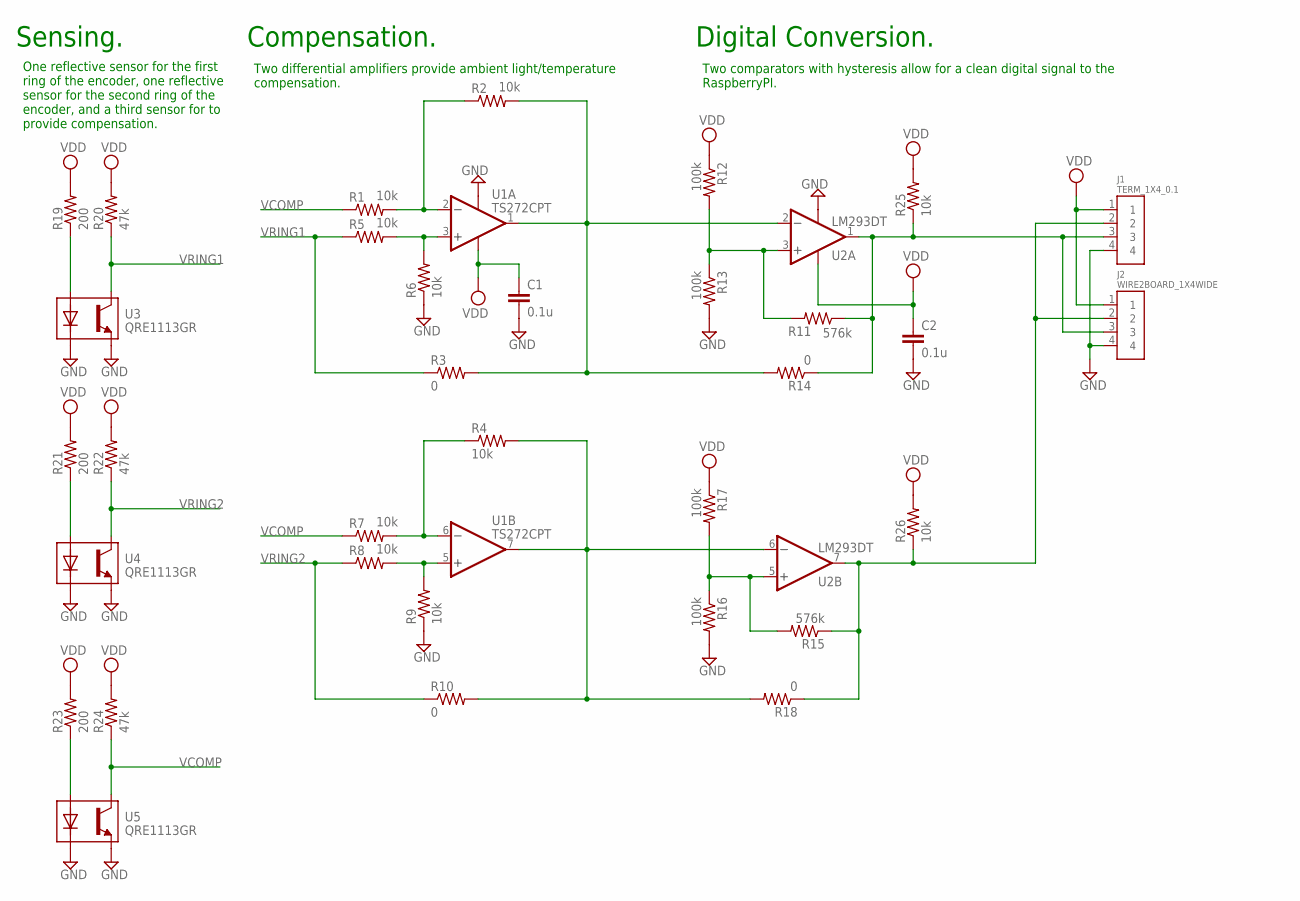
[picture p23: schematic dual-encoding.sch]

Parts:
C1, C2: 0.1u; C0805
J1: TERM_1X4_0.1
J2: WIRE2BOARD_1X4WIDE; WIRE2BOARD_1X4W
R1, R2, R4, R5, R6, R7, R8, R9, R25, R26: 10k; R0805
R3, R10, R14, R18: 0; R0805
R11, R15: 576k; R0805
R12, R13, R16, R17: 100k; R0805
R19, R21, R23: 200; R0805
R20, R22, R24: 47k; R0805
U1: TS272CPT; TSSOP8
U2: LM293DT; SOIC8
U3, U4, U5: QRE1113GR; REFL

Connections:
GND: C1.2, C2.2, J1.4, J2.4, R6.1, R9.1, R13.2, R16.2, U1.4 (V-), U2.4 (V-), U3.2 (DC), U3.4 (E), U4.2 (DC), U4.4 (E), U5.2 (DC), U5.4 (E)
unnamed: R5.2, R6.2, U1.3 (+IN)
unnamed: R1.2, R2.1, U1.2 (-IN)
unnamed: R2.2, R3.2, R14.2, U1.1 (OUT), U2.2 (-IN)
unnamed: R4.1, R7.2, U1.6 (-IN)
unnamed: R4.2, R10.2, R18.2, U1.7 (OUT), U2.6 (-IN)
unnamed: R8.2, R9.2, U1.5 (+IN)
unnamed: R11.2, R12.2, R13.1, U2.3 (+IN)
unnamed: J1.3, J2.3, R11.1, R14.1, R25.1, U2.1 (OUT)
unnamed: R19.1, U3.1 (DA)
unnamed: R15.2, R16.1, R17.2, U2.5 (+IN)
unnamed: J1.2, J2.2, R15.1, R18.1, R26.1, U2.7 (OUT)
unnamed: R21.1, U4.1 (DA)
unnamed: R23.1, U5.1 (DA)
VCOMP: R1.1, R7.1, R24.1, U5.3 (C)
VDD: C1.1, C2.1, J1.1, J2.1, R12.1, R17.1, R19.2, R20.2, R21.2, R22.2, R23.2, R24.2, R25.2, R26.2, U1.8 (V+), U2.8 (V+)
VRING1: R3.1, R5.1, R20.1, U3.3 (C)
VRING2: R8.1, R10.1, R22.1, U4.3 (C)

Notes on the sheet:
Sensing.
Compensation.
Two differential amplifiers provide ambient light/temperature compensation.
One reflective sensor for the first ring of the encoder, one reflective sensor for the second ring of the encoder, and a third sensor for to provide compensation.
Digital Conversion.
Two comparators with hysteresis allow for a clean digital signal to the RaspberryPI.

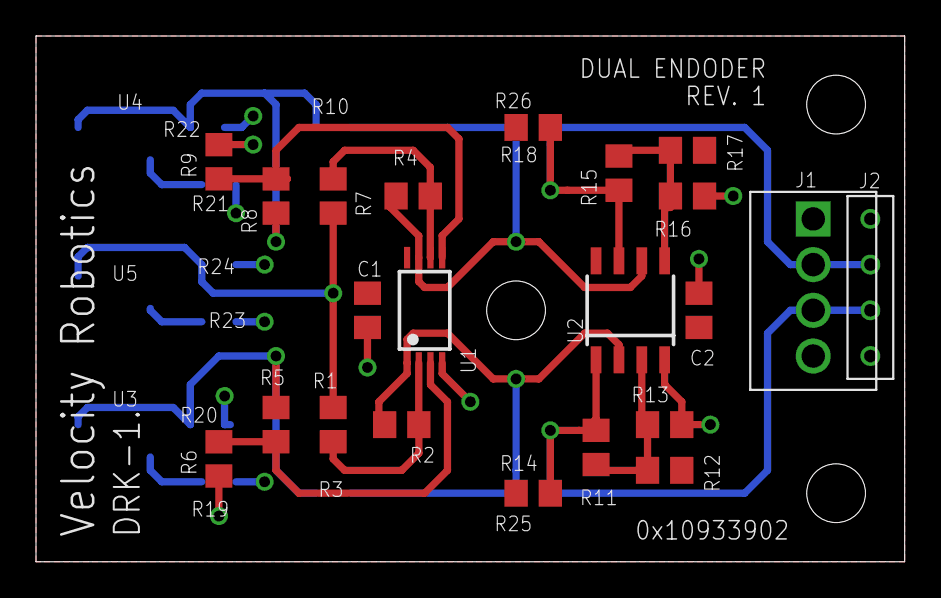
[picture p24: board dual-encoding.brd from above]

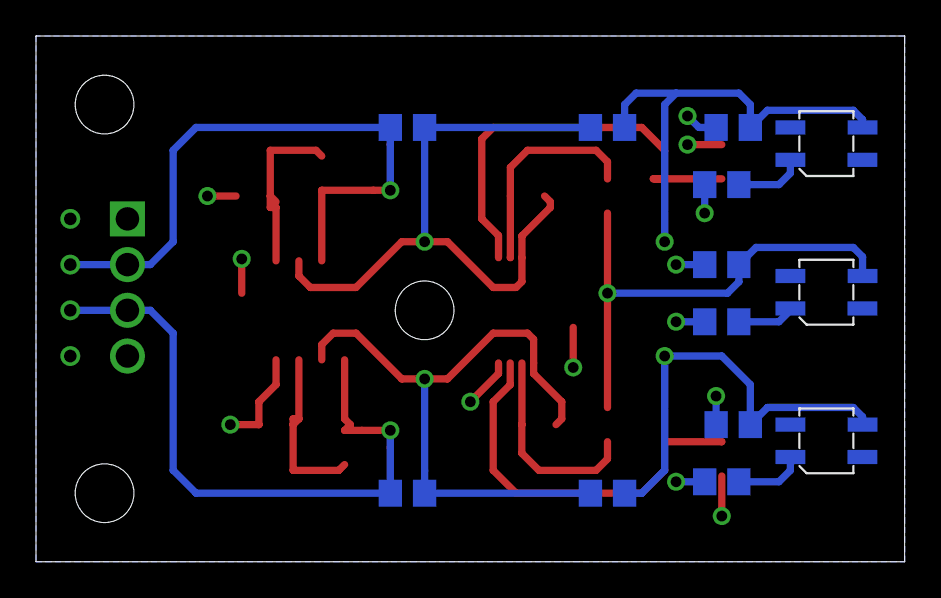
[picture p25: board dual-encoding.brd from below]

Board: 2 copper layers, 48.3 x 29.2 mm, 35 parts (13 on the bottom side), 18 nets.
