dsantorojr/velocity/MF-autoset-motor-control/power-motor.brd

## EAGLE design MF-autoset-motor-control/power-motor.brd (2016-12-03)

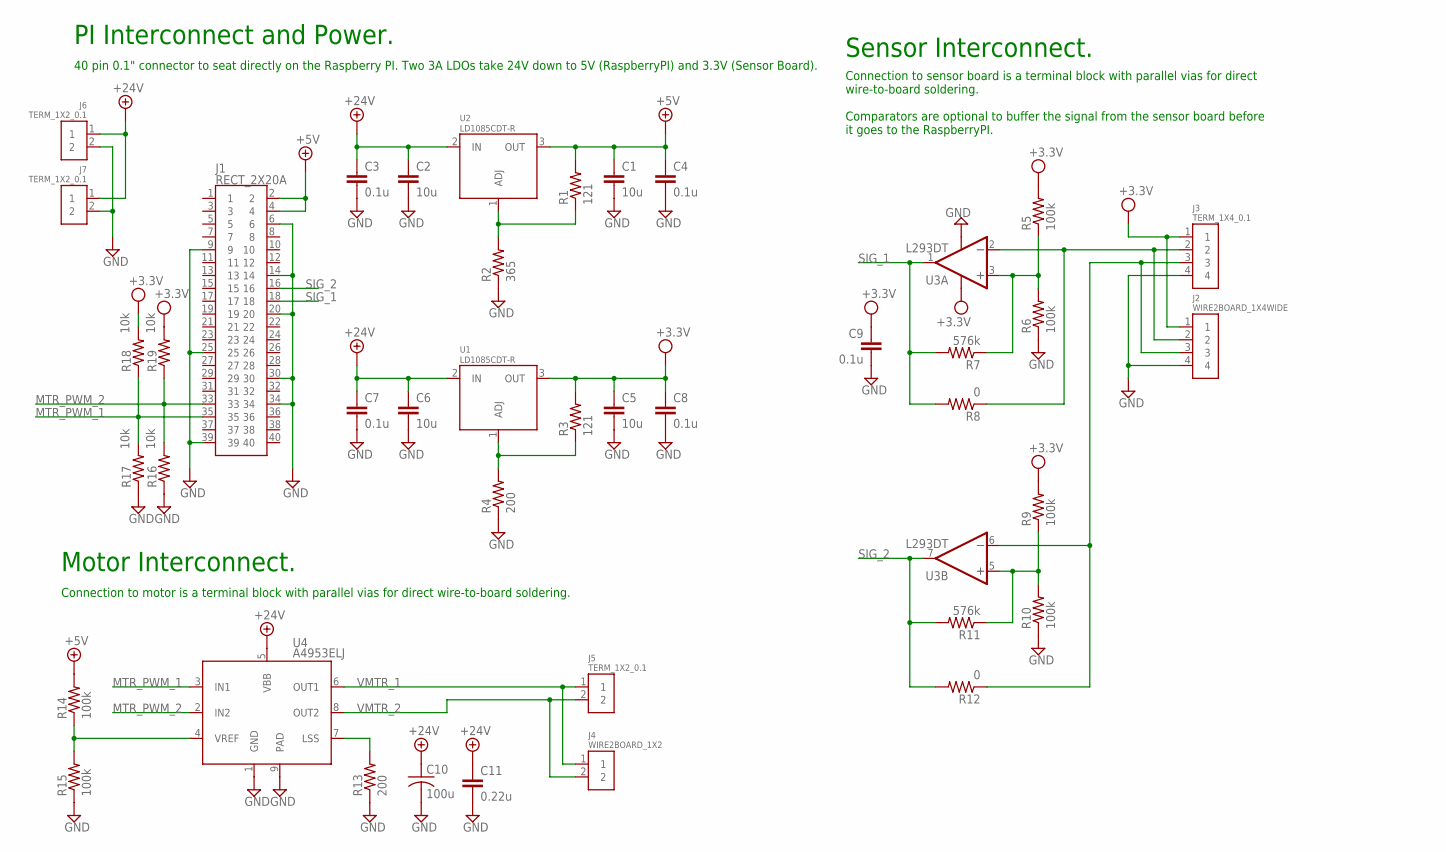
[picture p26: schematic power-motor.sch]

Parts:
C1, C2, C5, C6: 10u; C0805
C3, C4, C7, C8, C9: 0.1u; C0805
C10: 100u; CPOL-8
C11: 0.22u; C0805
J1: RECT_2X20A; RECT_2X20_0.1
J2: WIRE2BOARD_1X4WIDE; WIRE2BOARD_1X4W
J3: TERM_1X4_0.1
J4: WIRE2BOARD_1X2
J5, J6, J7: TERM_1X2_0.1
R1, R3: 121; R0805
R2: 365; R0805
R4: 200; R0805
R5, R6, R9, R10, R14, R15: 100k; R0805
R7, R11: 576k; R0805
R8, R12: 0; R0805
R13: 200; R2512
R16, R17, R18, R19: 10k; R0805
U1, U2: LD1085CDT-R; TO252
U3: L293DT; SOIC8
U4: A4953ELJ; SOIC8

Connections:
+5V: C1.1, C4.1, J1.2, J1.4, R1.2, R14.2, U2.3 (OUT)
+24V: C2.1, C3.1, C6.1, C7.1, C10.P$1 (1), C11.1, J6.1, J7.1, U1.2 (IN), U2.2 (IN), U4.5 (VBB)
GND: C1.2, C2.2, C3.2, C4.2, C5.2, C6.2, C7.2, C8.2, C9.2, C10.P$2 (2), C11.2, J1.6, J1.9, J1.14, J1.20, J1.25, J1.30, J1.34, J1.39, J2.4, J3.4, J6.2, J7.2, R2.1, R4.1, R6.1, R10.1, R13.1, R15.1, R16.1, R17.1, U3.4 (V-), U4.1 (GND), U4.9 (PAD)
MTR_PWM_1: J1.35, R17.2, R18.1, U4.3 (IN1)
MTR_PWM_2: J1.33, R16.2, R19.1, U4.2 (IN2)
unnamed: R5.1, R6.2, R7.1, U3.3 (+IN)
unnamed: R1.1, R2.2, U2.1 (ADJ)
unnamed: J2.2, J3.2, R8.1, U3.2 (-IN)
unnamed: J2.3, J3.3, R12.1, U3.6 (-IN)
unnamed: R3.1, R4.2, U1.1 (ADJ)
unnamed: R14.1, R15.2, U4.4 (VREF)
unnamed: R13.2, U4.7 (LSS)
unnamed: R9.1, R10.2, R11.1, U3.5 (+IN)
SIG_1: J1.18, R7.2, R8.2, U3.1 (OUT)
SIG_2: J1.16, R11.2, R12.2, U3.7 (OUT)
VDD: C5.1, C8.1, C9.1, J2.1, J3.1, R3.2, R5.2, R9.2, R18.2, R19.2, U1.3 (OUT), U3.8 (V+)
VMTR_1: J4.1, J5.1, U4.6 (OUT1)
VMTR_2: J4.2, J5.2, U4.8 (OUT2)

Notes on the sheet:
Sensor Interconnect.
Connection to sensor board is a terminal block with parallel vias for direct wire-to-board soldering. Comparators are optional to buffer the signal from the sensor board before it goes to the RaspberryPI.
Motor Interconnect.
Connection to motor is a terminal block with parallel vias for direct wire-to-board soldering.
PI Interconnect and Power.
40 pin 0.1" connector to seat directly on the Raspberry PI. Two 3A LDOs take 24V down to 5V (RaspberryPI) and 3.3V (Sensor Board).

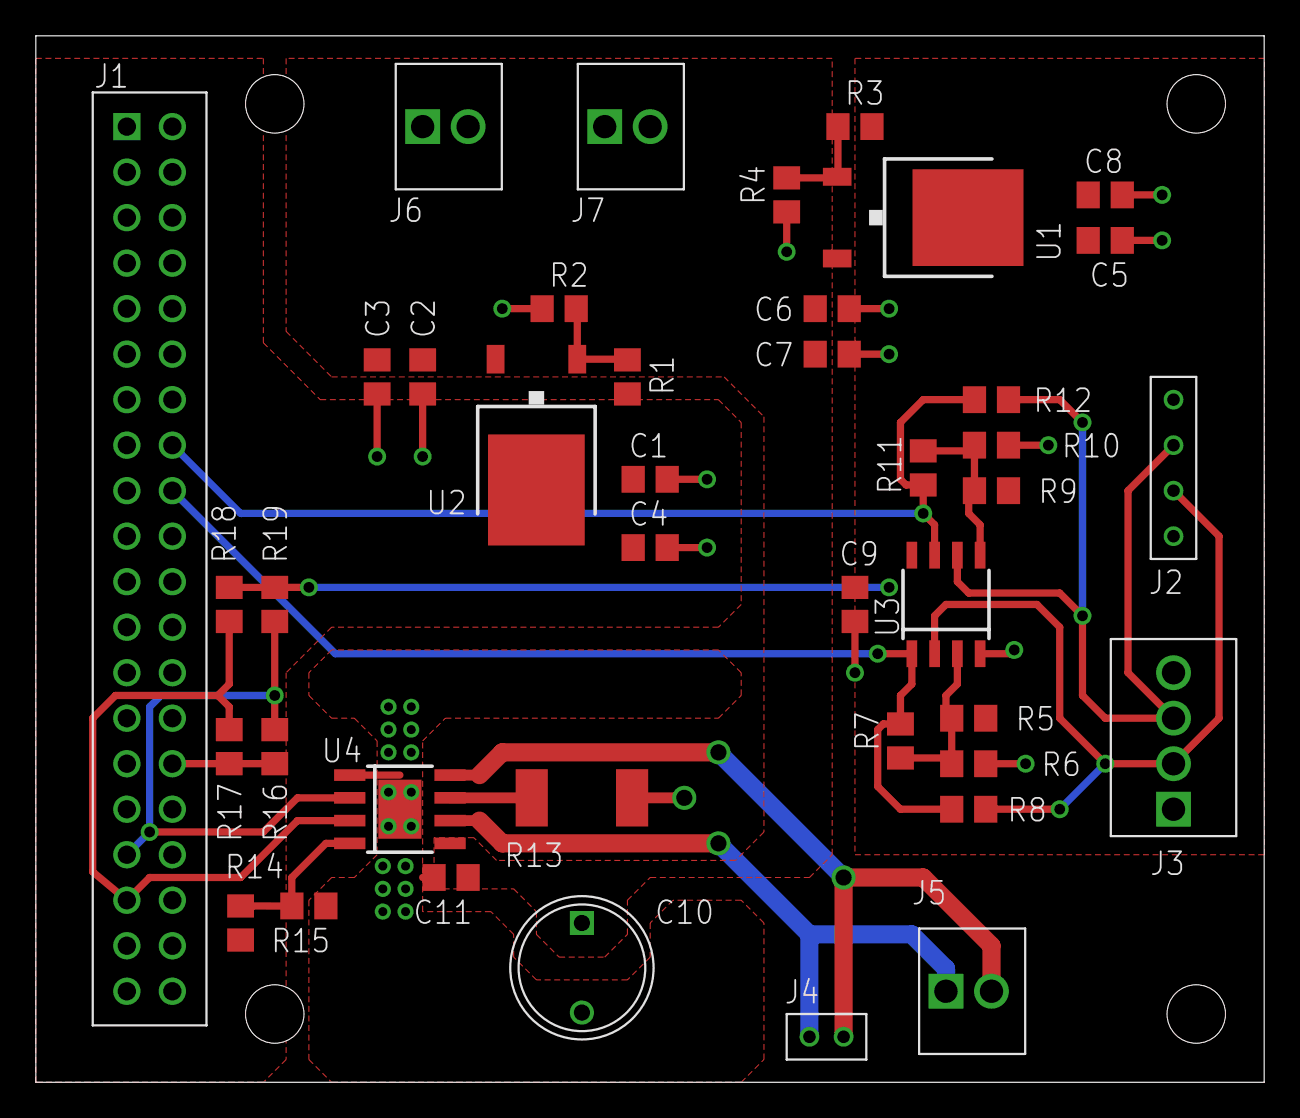
[picture p27: board power-motor.brd from above]

Board: 2 copper layers, 68.6 x 58.4 mm, 41 parts (0 on the bottom side), 18 nets.
