dsantorojr/velocity/(commit log)

2016-12-03 first github commit
    [autoset-main-BOM.csv, autoset-main.brd, autoset-main.sch, autoset-sensing-in.dxf, autoset-sensing-mm.dxf, autoset-sensing.brd, autoset-sensing.sch, dual-encoding.brd]
2016-12-06 Bord updates to go to 4 layers
    [autoset-sensing.brd]
2016-12-10 Multiple updates
    Library update (add switch)
    Updated sensing board to 4 layers, added some filtering.
    Updated control board to 4 layers, added functionality.
    [autoset-main.brd, autoset-main.sch, autoset-sensing.brd]
2016-12-12 Updates
    Sensing manufacture. Updated library. Updated main schematic to include
    magnetic sensor.
    [autoset-main.brd, autoset-main.sch]
2016-12-13 Main Board Updates
    Move things away from holes. Create mfg files
    [autoset-main.brd, autoset-main.sch]
2017-01-04 Supporting document and manufacturing update
    [autoset-main-BOM.csv, autoset-main.brd, autoset-main.sch, autoset-sensing-BOM.csv, autoset-sensing-in.dxf, autoset-sensing-mm.dxf, autoset-sensing.brd, autoset-sensing.csv]
2017-01-25 Google Drive Fix
    [autoset-main-BOM-out.csv, autoset-main-in.dxf, autoset-main-mm.dxf, autoset-main.brd, autoset-main.sch, autoset-sensing-BOM-out.csv, autoset-sensing-in.dxf, autoset-sensing-mm.dxf]
2017-02-26 New layout for sensor board
    [autoset-sensing-BOM-out.csv, autoset-sensing-BOM.csv, autoset-sensing-in.dxf, autoset-sensing-mm.dxf, autoset-sensing.brd, autoset-sensing.csv, autoset-sensing.sch]
